Jaycar-Electronics/WiFi-Controlled-Strip-Lighting/images/underside.jpg

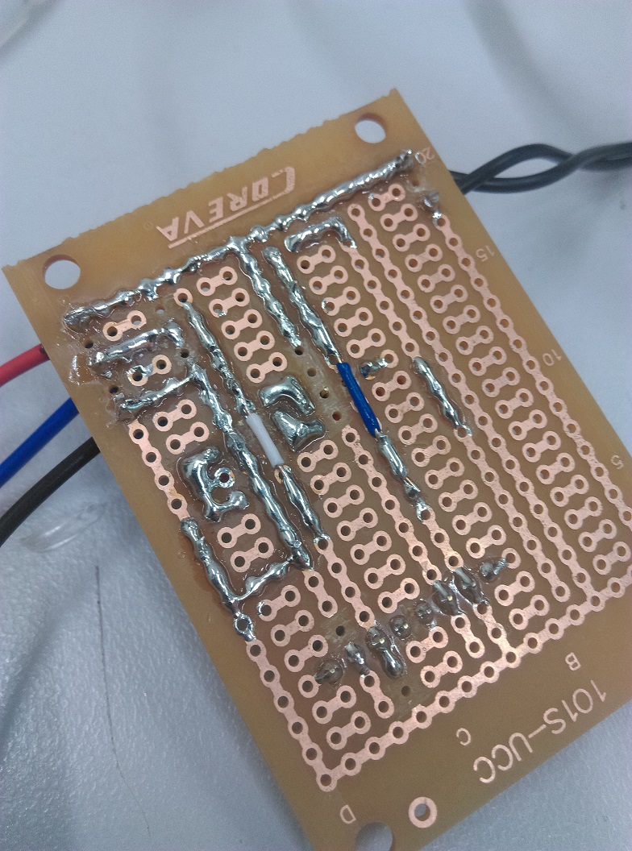
images/underside.jpg
