Jaycar-Electronics/WiFi-Controlled-Strip-Lighting/images/wires.jpg

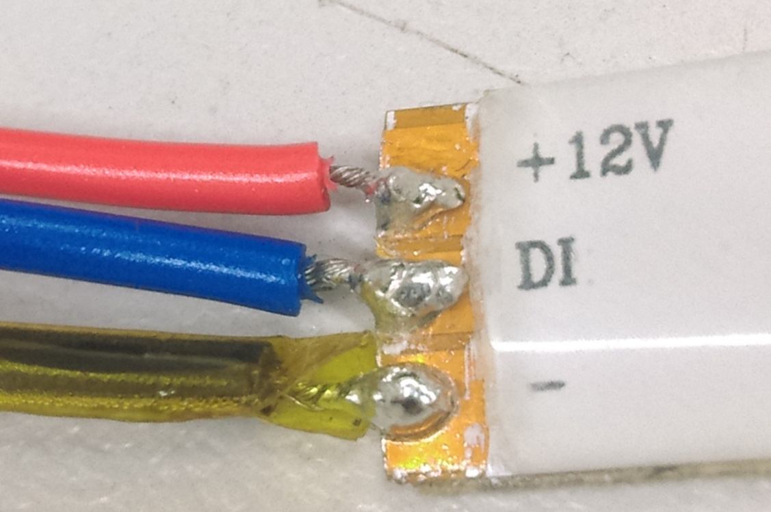
images/wires.jpg
