Jaycar-Electronics/WiFi-Controlled-Strip-Lighting/(threads)

Thread 1 (2019-10-18):

controller.ino will not compile

wrexy1994, 2019-10-18:
I assume that the variable 'rate' on line 76 is supposed to be 'currentRate'?

Jaycar-Electronics, 2019-10-20:
cheers, you're right, slipped by from re-factoring.
fixed in https://github.com/Jaycar-Electronics/WiFi-Controlled-Strip-Lighting/commit/2a7d196b862226820ff4aa7e5d0ec53dc8784818

Closed 2019-10-20.

Thread 3 (2019-11-06):

Made changes to the lightEffects.cpp

wrexy1994, 2019-11-06:
I have changed the Solid/Alternate so the lights alternate between colorOne and ColorTwo.
Changes are as follows:
Added line at 14: int phase = 0;
changes:
   case Alternate:
    for (int i = 0; i < n; i++)
    {
      if (i % 2 == phase)
        light.setPixelColor(i, colorOne);
      else
        light.setPixelColor(i, colorTwo);
    }
    phase = 1 - phase;
    break;

I think the Mix should be as follows:
  case Mix:
    for (int i = 0; i < n; i++)
    {
      light.setPixelColor(i, RED(colorOne) - redStep * i,
                          GREEN(colorOne) - greenStep * i,
                          BLUE(colorOne) - blueStep * i);
    }
    break;
Makes the strip light change from colorOne to ColorTwo. Do you agree?
Cheers

Jaycar-Electronics, 2019-11-06:
ah, you mean to interlace it? ( let's say for R = colour1 red, and B = colour2 blue ):
```plaintext
RBRBRBRBRBRB - instead of the current: - RRRRRRRRRBBBBBBBBB
```
I suppose that makes much more sense; I was thinking half-n-half but having alternate per pixel is a better idea

Do you want to try to submit a "pull request" or should I just add the changes and add  your username to a contribution list?

Jaycar-Electronics, 2019-12-13:
this has been changed in 43e4996

Let me know if that fixes it!
Thanks for bringing it to our attention.

Closed 2019-12-13.

Thread 6 (2020-10-12):

Tasmota

wrexy1994, 2020-10-12:
I have just flashed the ESP8266 with the Tasmota firmware (backed up first).
Changed the circuit; replaced 2N7000 with a pnp transistor e.g. BC558 or equivalent, 1k to a 1k8, and added 3k3 between D7 and base of transistor.
Find details at https://tasmota.github.io/docs/WS2812B-and-WS2813.
Configuration is D7 GPIO13 : WS2812 7
Needed to change SetOption37 to 7 (R,B,G,Wc,Ww) from default 0 for my strip to get the colours right.

Jaycar-Electronics, 2020-10-12:
very nice, I didn't see tasmota before; do you want to create a pull request? then I can get it merged into the main branch for others.

wrexy1994, 2020-10-12:
A pull request would be OK.
Just thought as an alternate, if anyone needed to control the strip through their home automation setup
You can go to their home page at https://tasmota.github.io/docs to find out more.
It has not the range of effects, but there are some, all accessed by sending web request to the device's IP address.
The command is "Scheme" for light effects, e.g. http://<ipaddress>/cm?cmnd=Scheme%208 starts to a "Christmas Pattern"
I suppose more "Schemes" could be added.
